shubham0x13/74hc165-module/74hc165-module.kicad_pcb

## KiCad design 74hc165-module.kicad_pcb (2026-10-16)

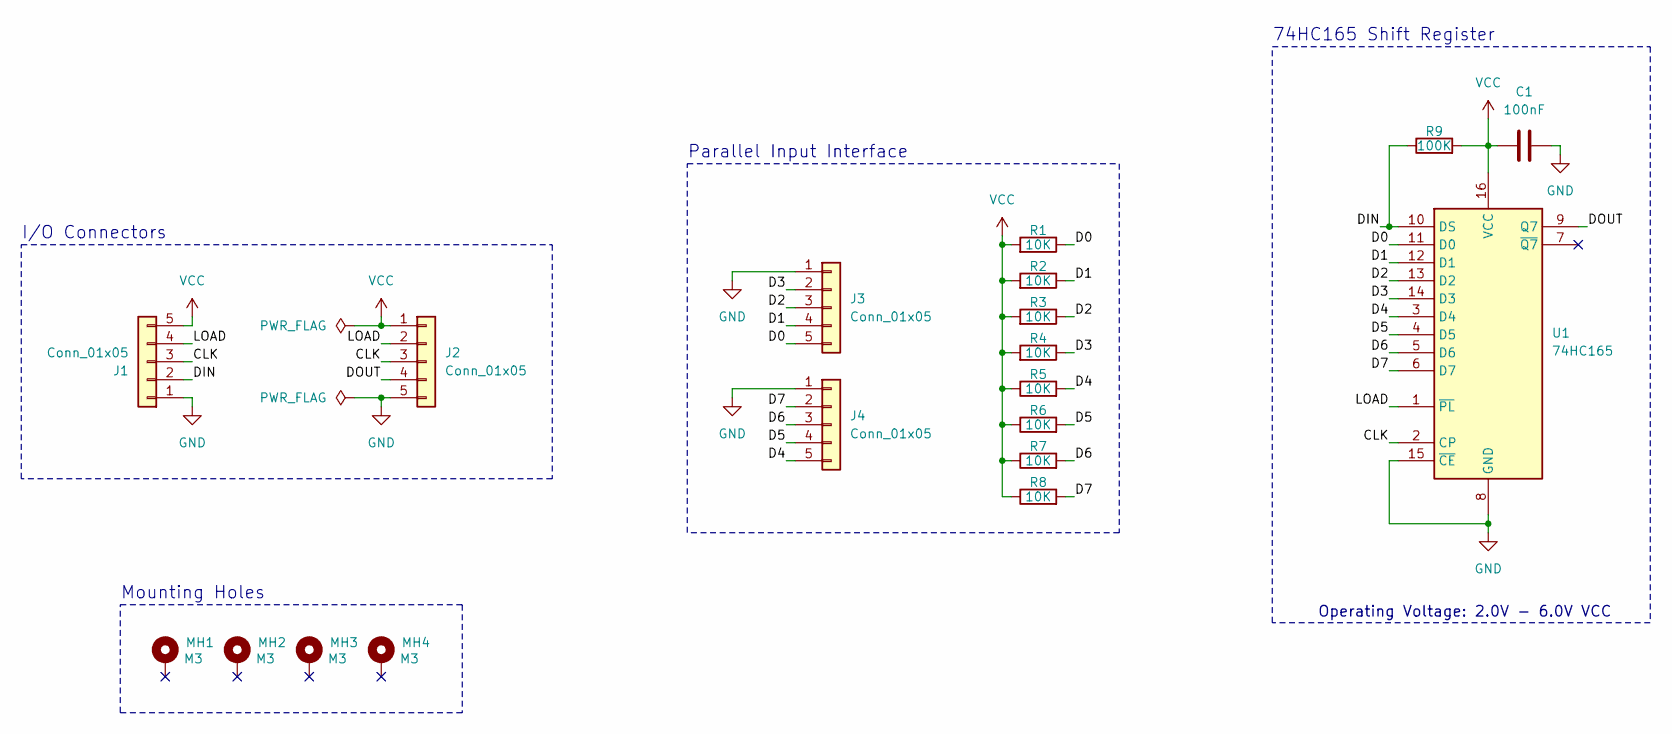
[picture p5: schematic 74hc165-module.kicad_sch, 74HC165 Shift Register Module]

Parts:
C1: 100nF; C_0603_1608Metric_Pad1.08x0.95mm_HandSolder
J1, J2, J3, J4: Conn_01x05; JST_XH_B5B-XH-A_1x05_P2.50mm_Vertical
MH1, MH2, MH3, MH4: M3; MountingHole_3.2mm_M3_Pad
R1, R2, R3, R4, R5, R6, R7, R8: 10K; R_0603_1608Metric_Pad0.98x0.95mm_HandSolder
R9: 100K; R_0603_1608Metric_Pad0.98x0.95mm_HandSolder
U1: 74HC165; SOIC-16_3.9x9.9mm_P1.27mm

Connections:
/CLK: J1.3, J2.3, U1.2 (CP)
/D0: J3.5, R1.1, U1.11 (D0)
/D1: J3.4, R2.1, U1.12 (D1)
/D2: J3.3, R3.1, U1.13 (D2)
/D3: J3.2, R4.1, U1.14 (D3)
/D4: J4.5, R5.2, U1.3 (D4)
/D5: J4.4, R6.2, U1.4 (D5)
/D6: J4.3, R7.2, U1.5 (D6)
/D7: J4.2, R8.2, U1.6 (D7)
/DIN: J1.2, R9.1, U1.10 (DS)
/DOUT: J2.4, U1.9 (Q7)
/LOAD: J1.4, J2.2, U1.1 (~PL)
GND: C1.2, J1.1, J2.5, J3.1, J4.1, U1.8 (GND), U1.15 (~CE)
VCC: C1.1, J1.5, J2.1, R1.2, R2.2, R3.2, R4.2, R5.1, R6.1, R7.1, R8.1, R9.2, U1.16 (VCC)

Notes on the sheet:
Parallel Input Interface
I/O Connectors
Operating Voltage: 2.0V - 6.0V VCC
74HC165 Shift Register
Mounting Holes

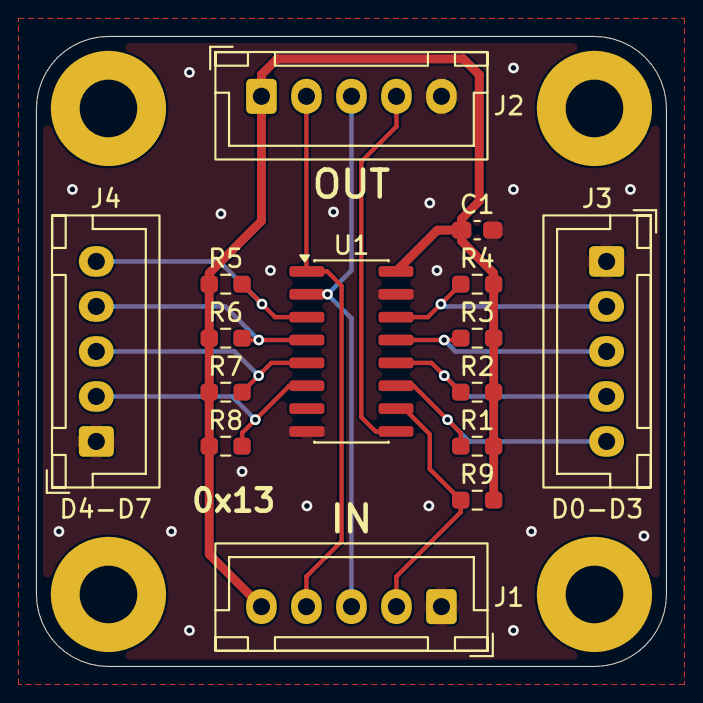
[picture p6: board 74hc165-module.kicad_pcb from above]

Board: 2 copper layers, 35.0 x 35.0 mm, 19 parts (0 on the bottom side), 14 nets.
