shubham0x13/74hc165-module/(notices)

Notices in the files:
README.md:
License: CERN-OHL-S v2
